jfryman/mw-cart/mega-wifi.kicad_pcb

## KiCad design mega-wifi.kicad_pcb (2026-10-06)

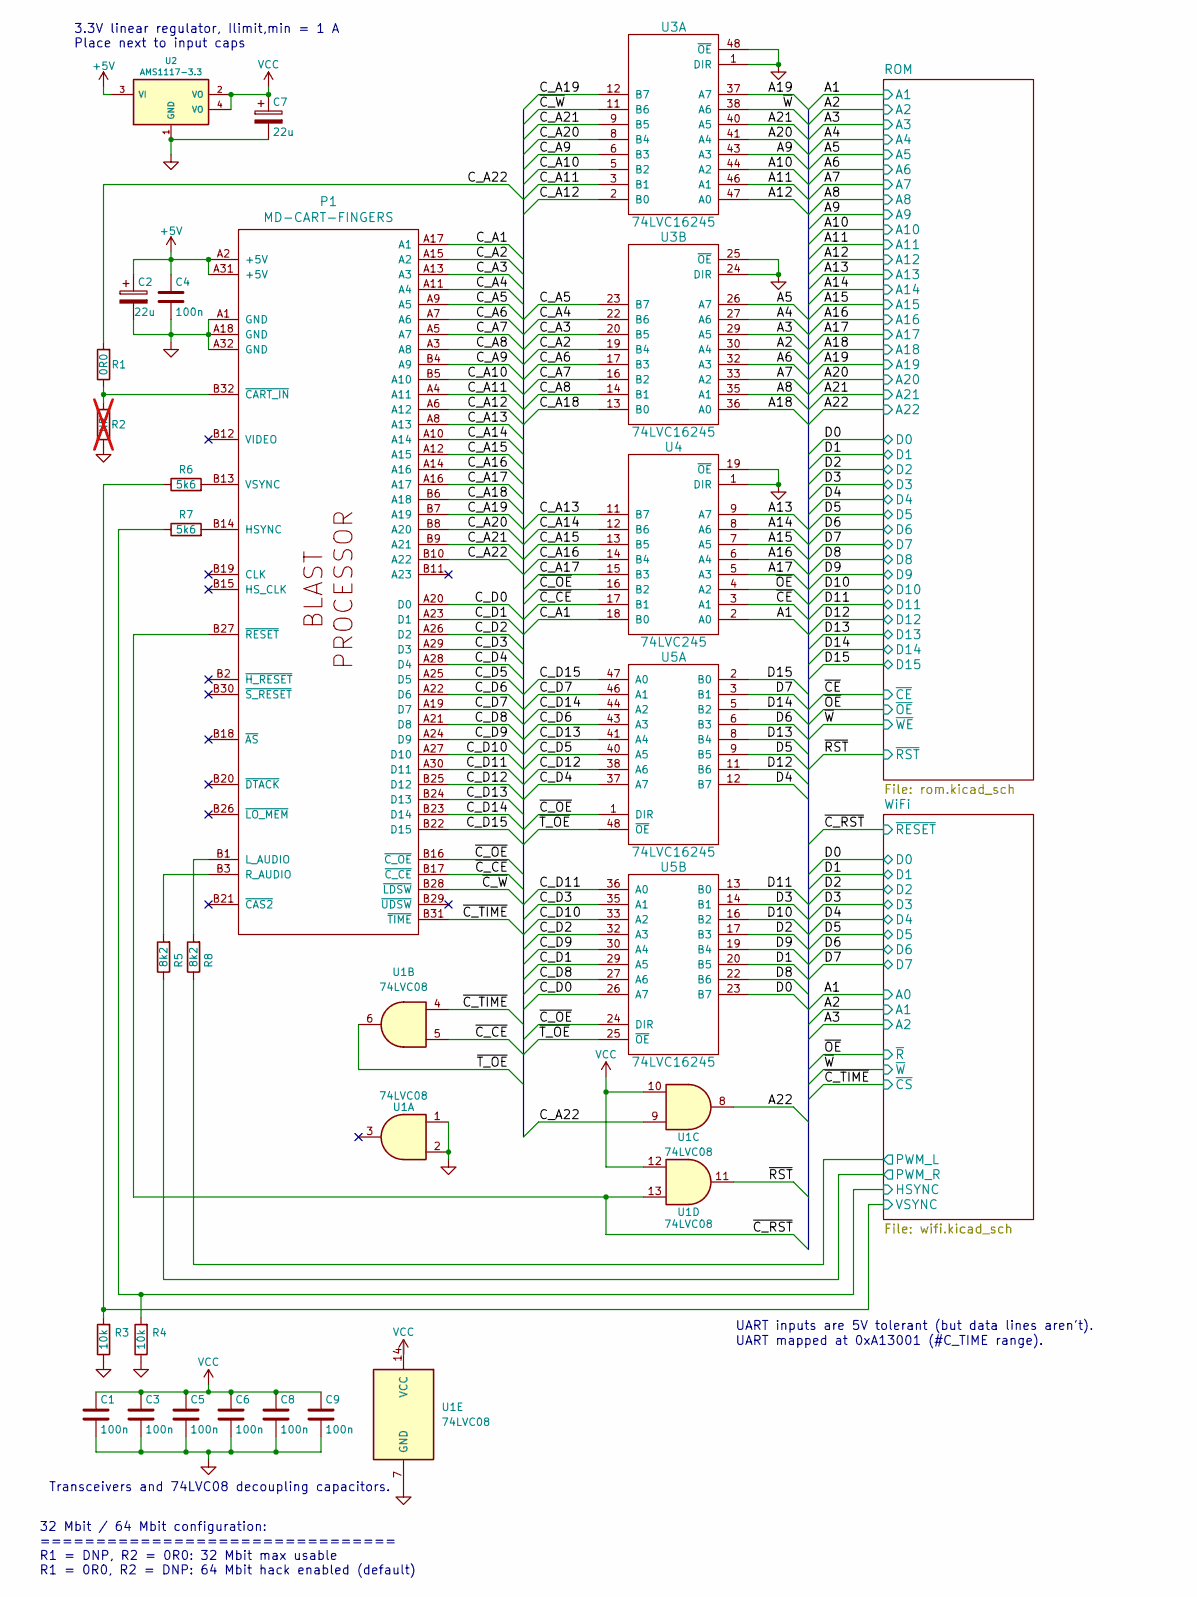
[picture p2: schematic mega-wifi.kicad_sch, MegaWiFi]

Parts:
C1, C3, C4, C5, C6, C8, C9: 100n; C_0603_1608Metric; LCSC# C14663
C2, C7: 22u; C_1206_3216Metric; LCSC# C12891
P1: MD-CART-FINGERS
R1: 0R0; R_0603_1608Metric; LCSC# C21189
R2: NP; R_0603_1608Metric; not fitted
R3, R4: 10k; R_0603_1608Metric; LCSC# C25804
R5, R8: 8k2; R_0603_1608Metric; LCSC# C25981
R6, R7: 5k6; R_0603_1608Metric; LCSC# C23189
U1: 74LVC08; TSSOP-14_4.4x5mm_P0.65mm; LCSC# C6053
U2: AMS1117-3.3; SOT-223; LCSC# C6186
U3, U5: 74LVC16245; TSSOP-48_6.1x12.5mm_P0.5mm; LCSC# C7824
U4: 74LVC245; TSSOP-20_4.4x6.5mm_P0.65mm; LCSC# C7848

Connections:
+5V: C2.1, C4.1, P1.A2 (+5V), P1.A31 (+5V), U2.3 (VI); also elsewhere on the board
/A1: U4.2 (A0); also elsewhere on the board
/A2: U3.30 (A4); also elsewhere on the board
/A3: U3.29 (A5); also elsewhere on the board
/A4: U3.27 (A6); also elsewhere on the board
/A5: U3.26 (A7); also elsewhere on the board
/A6: U3.32 (A3); also elsewhere on the board
/A7: U3.33 (A2); also elsewhere on the board
/A8: U3.35 (A1); also elsewhere on the board
/A9: U3.43 (A3); also elsewhere on the board
/A10: U3.44 (A2); also elsewhere on the board
/A11: U3.46 (A1); also elsewhere on the board
/A12: U3.47 (A0); also elsewhere on the board
/A13: U4.9 (A7); also elsewhere on the board
/A14: U4.8 (A6); also elsewhere on the board
/A15: U4.7 (A5); also elsewhere on the board
/A16: U4.6 (A4); also elsewhere on the board
/A17: U4.5 (A3); also elsewhere on the board
/A18: U3.36 (A0); also elsewhere on the board
/A19: U3.37 (A7); also elsewhere on the board
/A20: U3.41 (A4); also elsewhere on the board
/A21: U3.40 (A5); also elsewhere on the board
/A22: U1.8; also elsewhere on the board
/C_A1: P1.A17 (A1), U4.18 (B0)
/C_A2: P1.A15 (A2), U3.19 (B4)
/C_A3: P1.A13 (A3), U3.20 (B5)
/C_A4: P1.A11 (A4), U3.22 (B6)
/C_A5: P1.A9 (A5), U3.23 (B7)
/C_A6: P1.A7 (A6), U3.17 (B3)
/C_A7: P1.A5 (A7), U3.16 (B2)
/C_A8: P1.A3 (A8), U3.14 (B1)
/C_A9: P1.B4 (A9), U3.6 (B3)
/C_A10: P1.B5 (A10), U3.5 (B2)
/C_A11: P1.A4 (A11), U3.3 (B1)
/C_A12: P1.A6 (A12), U3.2 (B0)
/C_A13: P1.A8 (A13), U4.11 (B7)
/C_A14: P1.A10 (A14), U4.12 (B6)
/C_A15: P1.A12 (A15), U4.13 (B5)
/C_A16: P1.A14 (A16), U4.14 (B4)
/C_A17: P1.A16 (A17), U4.15 (B3)
/C_A18: P1.B6 (A18), U3.13 (B0)
/C_A19: P1.B7 (A19), U3.12 (B7)
/C_A20: P1.B8 (A20), U3.8 (B4)
/C_A21: P1.B9 (A21), U3.9 (B5)
/C_A22: P1.B10 (A22), R1.2, U1.9
/C_D0: P1.A20 (D0), U5.26 (A7)
/C_D1: P1.A23 (D1), U5.29 (A5)
/C_D2: P1.A26 (D2), U5.32 (A3)
/C_D3: P1.A29 (D3), U5.35 (A1)
/C_D4: P1.A28 (D4), U5.37 (A7)
/C_D5: P1.A25 (D5), U5.40 (A5)
/C_D6: P1.A22 (D6), U5.43 (A3)
/C_D7: P1.A19 (D7), U5.46 (A1)
/C_D8: P1.A21 (D8), U5.27 (A6)
/C_D9: P1.A24 (D9), U5.30 (A4)
/C_D10: P1.A27 (D10), U5.33 (A2)
/C_D11: P1.A30 (D11), U5.36 (A0)
/C_D12: P1.B25 (D12), U5.38 (A6)
/C_D13: P1.B24 (D13), U5.41 (A4)
/C_D14: P1.B23 (D14), U5.44 (A2)
/C_D15: P1.B22 (D15), U5.47 (A0)
/D0: U5.23 (B7); also elsewhere on the board
/D1: U5.20 (B5); also elsewhere on the board
/D2: U5.17 (B3); also elsewhere on the board
/D3: U5.14 (B1); also elsewhere on the board
/D4: U5.12 (B7); also elsewhere on the board
/D5: U5.9 (B5); also elsewhere on the board
/D6: U5.6 (B3); also elsewhere on the board
/D7: U5.3 (B1); also elsewhere on the board
/D8: U5.22 (B6); also elsewhere on the board
/D9: U5.19 (B4); also elsewhere on the board
/D10: U5.16 (B2); also elsewhere on the board
/D11: U5.13 (B0); also elsewhere on the board
/D12: U5.11 (B6); also elsewhere on the board
/D13: U5.8 (B4); also elsewhere on the board
/D14: U5.5 (B2); also elsewhere on the board
/D15: U5.2 (B0); also elsewhere on the board
/WiFi/HSYNC: R4.2, R7.1; also elsewhere on the board
/WiFi/PWM_L: R8.1; also elsewhere on the board
/WiFi/PWM_R: R5.1; also elsewhere on the board
/WiFi/VSYNC: R3.2, R6.1; also elsewhere on the board
/~CE: U4.3 (A1); also elsewhere on the board
/~C_CE: P1.B17 (~C_CE), U1.5, U4.17 (B1)
/~C_OE: P1.B16 (~C_OE), U4.16 (B2), U5.1 (DIR), U5.24 (DIR)
/~C_RST: P1.B27 (~RESET), U1.13; also elsewhere on the board
/~C_TIME: P1.B31 (~TIME), U1.4; also elsewhere on the board
/~C_W: P1.B28 (~LDSW), U3.11 (B6)
/~OE: U4.4 (A2); also elsewhere on the board
/~RST: U1.11; also elsewhere on the board
/~T_OE: U1.6, U5.25 (~OE), U5.48 (~OE)
/~W: U3.38 (A6); also elsewhere on the board
GND: C1.2, C2.2, C3.2, C4.2, C5.2, C6.2, C7.2, C8.2, C9.2, P1.A1 (GND), P1.A18 (GND), P1.A32 (GND), R2.1, R3.1, R4.1, U1.1, U1.2, U1.7 (GND), U2.1 (GND), U3.1 (DIR), U3.4 (GND), U3.10 (GND), U3.15 (GND), U3.21 (GND), U3.24 (DIR), U3.25 (~OE), U3.28 (GND), U3.34 (GND), U3.39 (GND), U3.45 (GND), U3.48 (~OE), U4.1 (DIR), U4.10 (GND), U4.19 (~OE), U5.4 (GND), U5.10 (GND), U5.15 (GND), U5.21 (GND), U5.28 (GND), U5.34 (GND), U5.39 (GND), U5.45 (GND); also elsewhere on the board
unnamed: P1.B14 (HSYNC), R7.2
unnamed: P1.B1 (L_AUDIO), R8.2
unnamed: P1.B3 (R_AUDIO), R5.2
unnamed: P1.B13 (VSYNC), R6.2
unnamed: P1.B32 (~CART_IN), R1.1, R2.2
VCC: C1.1, C3.1, C5.1, C6.1, C7.1, C8.1, C9.1, U1.10, U1.12, U1.14 (VCC), U2.2 (VO), U2.4 (VO), U3.7 (VCC), U3.18 (VCC), U3.31 (VCC), U3.42 (VCC), U4.20 (VCC), U5.7 (VCC), U5.18 (VCC), U5.31 (VCC), U5.42 (VCC); also elsewhere on the board

Notes on the sheet:
UART mapped at 0xA13001 (#C_TIME range).
32 Mbit / 64 Mbit configuration: ================================ R1 = DNP, R2 = 0R0: 32 Mbit max usable R1 = 0R0, R2 = DNP: 64 Mbit hack enabled (default)
Transceivers and 74LVC08 decoupling capacitors.
UART inputs are 5V tolerant (but data lines aren't).
3.3V linear regulator, Ilimit,min = 1 A Place next to input caps

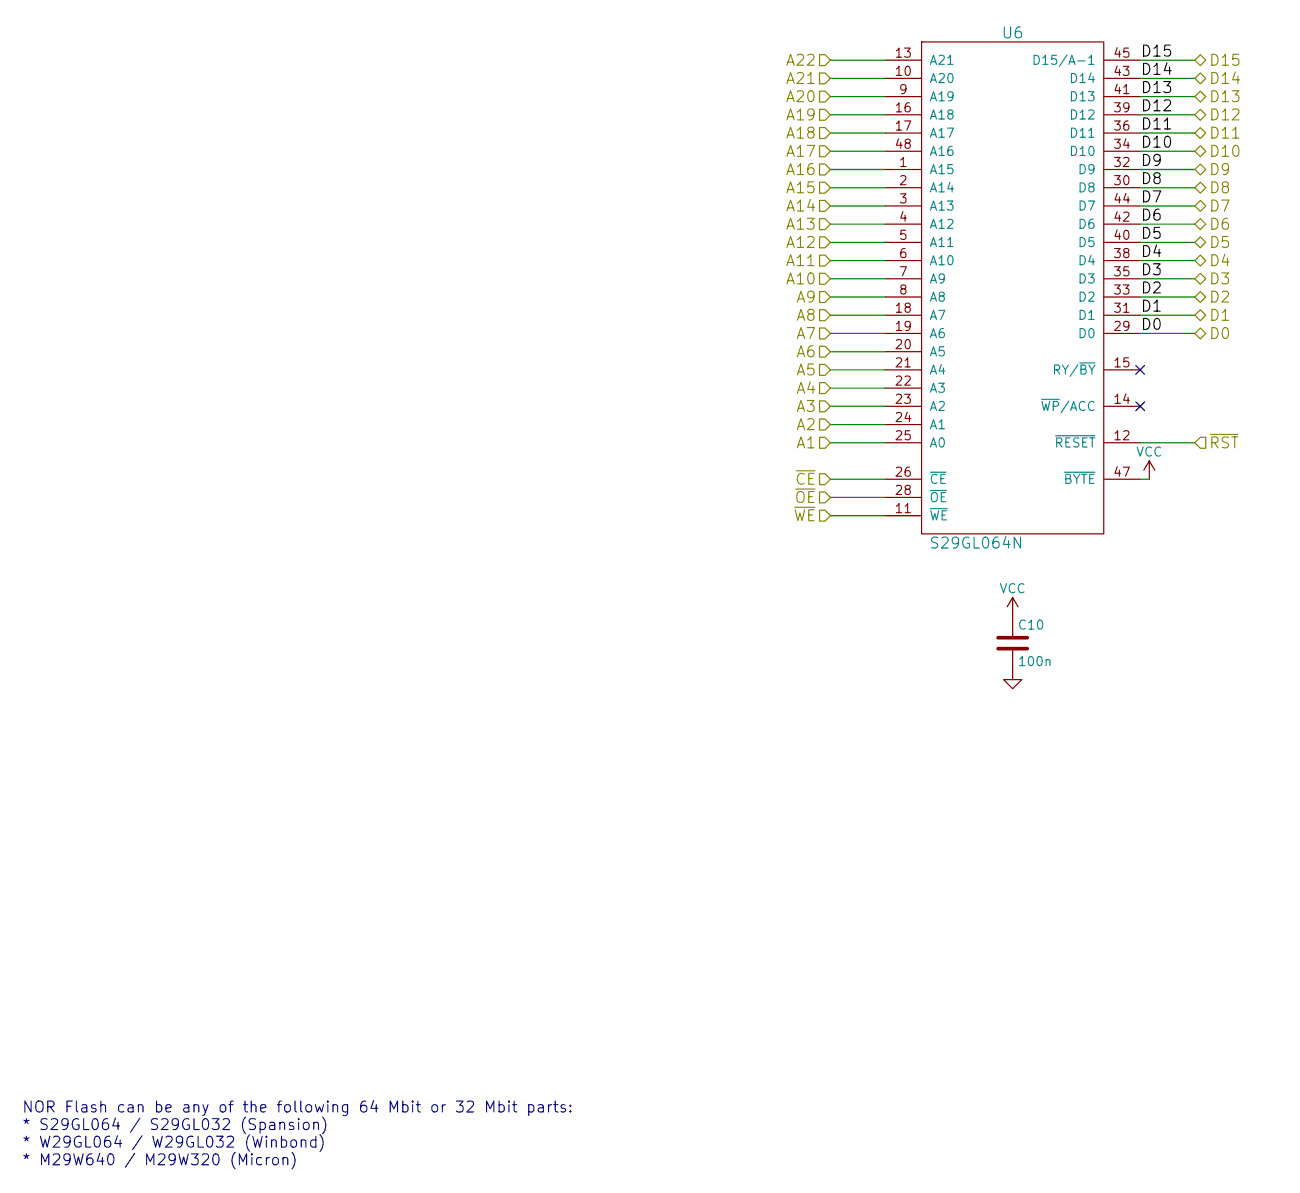
[picture p3: schematic rom.kicad_sch, MegaWiFi]

Parts:
C10: 100n; C_0603_1608Metric; LCSC# C14663
U6: S29GL064N; TSOP-I-48_18.4x12mm_P0.5mm; LCSC# C117907

Connections:
/A1: U6.25 (A0); also elsewhere on the board
/A2: U6.24 (A1); also elsewhere on the board
/A3: U6.23 (A2); also elsewhere on the board
/A4: U6.22 (A3); also elsewhere on the board
/A5: U6.21 (A4); also elsewhere on the board
/A6: U6.20 (A5); also elsewhere on the board
/A7: U6.19 (A6); also elsewhere on the board
/A8: U6.18 (A7); also elsewhere on the board
/A9: U6.8 (A8); also elsewhere on the board
/A10: U6.7 (A9); also elsewhere on the board
/A11: U6.6 (A10); also elsewhere on the board
/A12: U6.5 (A11); also elsewhere on the board
/A13: U6.4 (A12); also elsewhere on the board
/A14: U6.3 (A13); also elsewhere on the board
/A15: U6.2 (A14); also elsewhere on the board
/A16: U6.1 (A15); also elsewhere on the board
/A17: U6.48 (A16); also elsewhere on the board
/A18: U6.17 (A17); also elsewhere on the board
/A19: U6.16 (A18); also elsewhere on the board
/A20: U6.9 (A19); also elsewhere on the board
/A21: U6.10 (A20); also elsewhere on the board
/A22: U6.13 (A21); also elsewhere on the board
/D0: U6.29 (D0); also elsewhere on the board
/D1: U6.31 (D1); also elsewhere on the board
/D2: U6.33 (D2); also elsewhere on the board
/D3: U6.35 (D3); also elsewhere on the board
/D4: U6.38 (D4); also elsewhere on the board
/D5: U6.40 (D5); also elsewhere on the board
/D6: U6.42 (D6); also elsewhere on the board
/D7: U6.44 (D7); also elsewhere on the board
/D8: U6.30 (D8); also elsewhere on the board
/D9: U6.32 (D9); also elsewhere on the board
/D10: U6.34 (D10); also elsewhere on the board
/D11: U6.36 (D11); also elsewhere on the board
/D12: U6.39 (D12); also elsewhere on the board
/D13: U6.41 (D13); also elsewhere on the board
/D14: U6.43 (D14); also elsewhere on the board
/D15: U6.45 (D15/A-1); also elsewhere on the board
/~CE: U6.26 (~CE); also elsewhere on the board
/~OE: U6.28 (~OE); also elsewhere on the board
/~RST: U6.12 (~RESET); also elsewhere on the board
/~W: U6.11 (~WE); also elsewhere on the board
GND: C10.2, U6.27 (GND), U6.46 (GND); also elsewhere on the board
VCC: C10.1, U6.37 (VCC), U6.47 (~BYTE); also elsewhere on the board

Notes on the sheet:
NOR Flash can be any of the following 64 Mbit or 32 Mbit parts: * S29GL064 / S29GL032 (Spansion) * W29GL064 / W29GL032 (Winbond) * M29W640 / M29W320 (Micron)

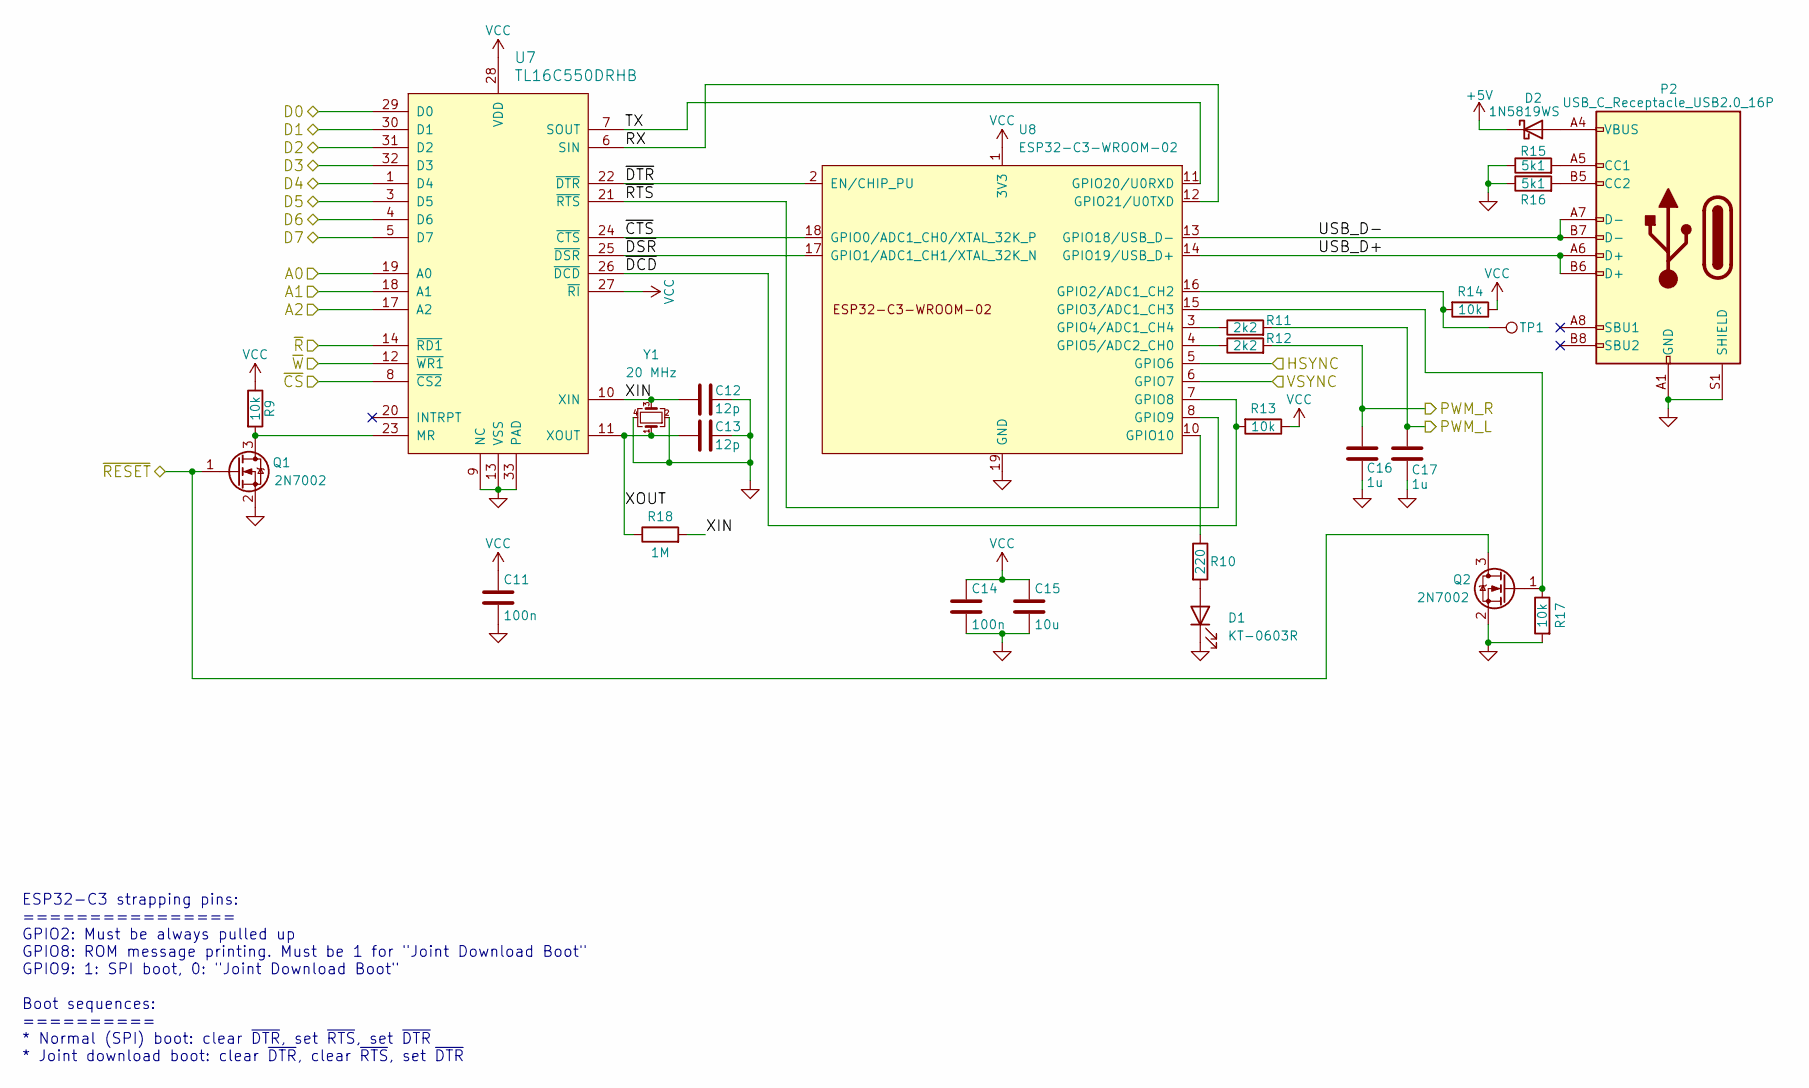
[picture p4: schematic wifi.kicad_sch, MegaWiFi]

Parts:
C11, C14: 100n; C_0603_1608Metric; LCSC# C14663
C12, C13: 12p; C_0603_1608Metric; LCSC# C38523
C15: 10u; C_0805_2012Metric; LCSC# C15850
C16, C17: 1u; C_0805_2012Metric; LCSC# C28323
D1: KT-0603R; LED_0603_1608Metric; LCSC# C2286
D2: 1N5819WS; D_SOD-323; LCSC# C191023
P2: USB_C_Receptacle_USB2.0_16P; USB_C_Receptacle_HCTL_HC-TYPE-C-16P-01A; LCSC# C709357
Q1, Q2: 2N7002; SOT-23; LCSC# C8545
R9, R13, R14, R17: 10k; R_0603_1608Metric; LCSC# C25804
R10: 220; R_0603_1608Metric; LCSC# C22962
R11, R12: 2k2; R_0603_1608Metric; LCSC# C4177
R15, R16: 5k1; R_0402_1005Metric; LCSC# C25905
R18: 1M; R_0402_1005Metric; LCSC# C26083
TP1: TestPoint; TestPoint_Pad_D1.0mm
U7: TL16C550DRHB; Texas_RHB0032E_VQFN-32-1EP_5x5mm_P0.5mm_EP3.45x3.45mm; LCSC# C2653239
U8: ESP32-C3-WROOM-02; LCSC# C2934560
Y1: 20 MHz; Crystal_SMD_2520-4Pin_2.5x2.0mm; LCSC# C252261

Connections:
+5V: D2.1 (K); also elsewhere on the board
/A1: U7.19 (A0); also elsewhere on the board
/A2: U7.18 (A1); also elsewhere on the board
/A3: U7.17 (A2); also elsewhere on the board
/D0: U7.29 (D0); also elsewhere on the board
/D1: U7.30 (D1); also elsewhere on the board
/D2: U7.31 (D2); also elsewhere on the board
/D3: U7.32 (D3); also elsewhere on the board
/D4: U7.1 (D4); also elsewhere on the board
/D5: U7.3 (D5); also elsewhere on the board
/D6: U7.4 (D6); also elsewhere on the board
/D7: U7.5 (D7); also elsewhere on the board
/WiFi/HSYNC: U8.5 (GPIO6); also elsewhere on the board
/WiFi/PWM_L: C17.1, R11.2; also elsewhere on the board
/WiFi/PWM_R: C16.1, R12.2; also elsewhere on the board
/WiFi/RX: U7.6 (SIN), U8.12 (GPIO21/U0TXD)
/WiFi/TX: U7.7 (SOUT), U8.11 (GPIO20/U0RXD)
/WiFi/USB_D+: P2.A6 (D+), P2.B6 (D+), U8.14 (GPIO19/USB_D+)
/WiFi/USB_D-: P2.A7 (D-), P2.B7 (D-), U8.13 (GPIO18/USB_D-)
/WiFi/VSYNC: U8.6 (GPIO7); also elsewhere on the board
/WiFi/XIN: C12.2, R18.2, U7.10 (XIN), Y1.3
/WiFi/XOUT: C13.2, R18.1, U7.11 (XOUT), Y1.1
/WiFi/~CTS: U7.24 (~CTS), U8.18 (GPIO0/ADC1_CH0/XTAL_32K_P)
/WiFi/~DCD: R13.2, U7.26 (~DCD), U8.7 (GPIO8)
/WiFi/~DSR: U7.25 (~DSR), U8.17 (GPIO1/ADC1_CH1/XTAL_32K_N)
/WiFi/~DTR: U7.22 (~DTR), U8.2 (EN/CHIP_PU)
/WiFi/~RTS: U7.21 (~RTS), U8.8 (GPIO9)
/~C_RST: Q1.1 (G), Q2.3 (D); also elsewhere on the board
/~C_TIME: U7.8 (~CS2); also elsewhere on the board
/~OE: U7.14 (~RD1); also elsewhere on the board
/~W: U7.12 (~WR1); also elsewhere on the board
GND: C11.2, C12.1, C13.1, C14.2, C15.2, C16.2, C17.2, D1.1 (K), P2.A1 (GND), P2.A12 (GND), P2.B1 (GND), P2.B12 (GND), P2.S1 (SHIELD), Q1.2 (S), Q2.2 (S), R15.1, R16.1, R17.2, U7.9 (NC), U7.13 (VSS), U7.33 (PAD), U8.9 (GND), U8.19 (GND), Y1.2, Y1.4; also elsewhere on the board
unnamed: D1.2 (A), R10.2
unnamed: D2.2 (A), P2.A4 (VBUS), P2.A9 (VBUS), P2.B4 (VBUS), P2.B9 (VBUS)
unnamed: P2.A5 (CC1), R15.2
unnamed: P2.B5 (CC2), R16.2
unnamed: Q1.3 (D), R9.2, U7.23 (MR)
unnamed: Q2.1 (G), R17.1, U8.15 (GPIO3/ADC1_CH3)
unnamed: R14.2, TP1.1, U8.16 (GPIO2/ADC1_CH2)
unnamed: R11.1, U8.3 (GPIO4/ADC1_CH4)
unnamed: R12.1, U8.4 (GPIO5/ADC2_CH0)
unnamed: R10.1, U8.10 (GPIO10)
VCC: C11.1, C14.1, C15.1, R9.1, R13.1, R14.1, U7.27 (~RI), U7.28 (VDD), U8.1 (3V3); also elsewhere on the board

Notes on the sheet:
ESP32-C3 strapping pins: ================ GPIO2: Must be always pulled up GPIO8: ROM message printing. Must be 1 for "Joint Download Boot" GPIO9: 1: SPI boot, 0: "Joint Download Boot" Boot sequences: ========== * Normal (SPI) boot: clear ~{DTR}, set ~{RTS}, set ~{DTR} * Joint download boot: clear ~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

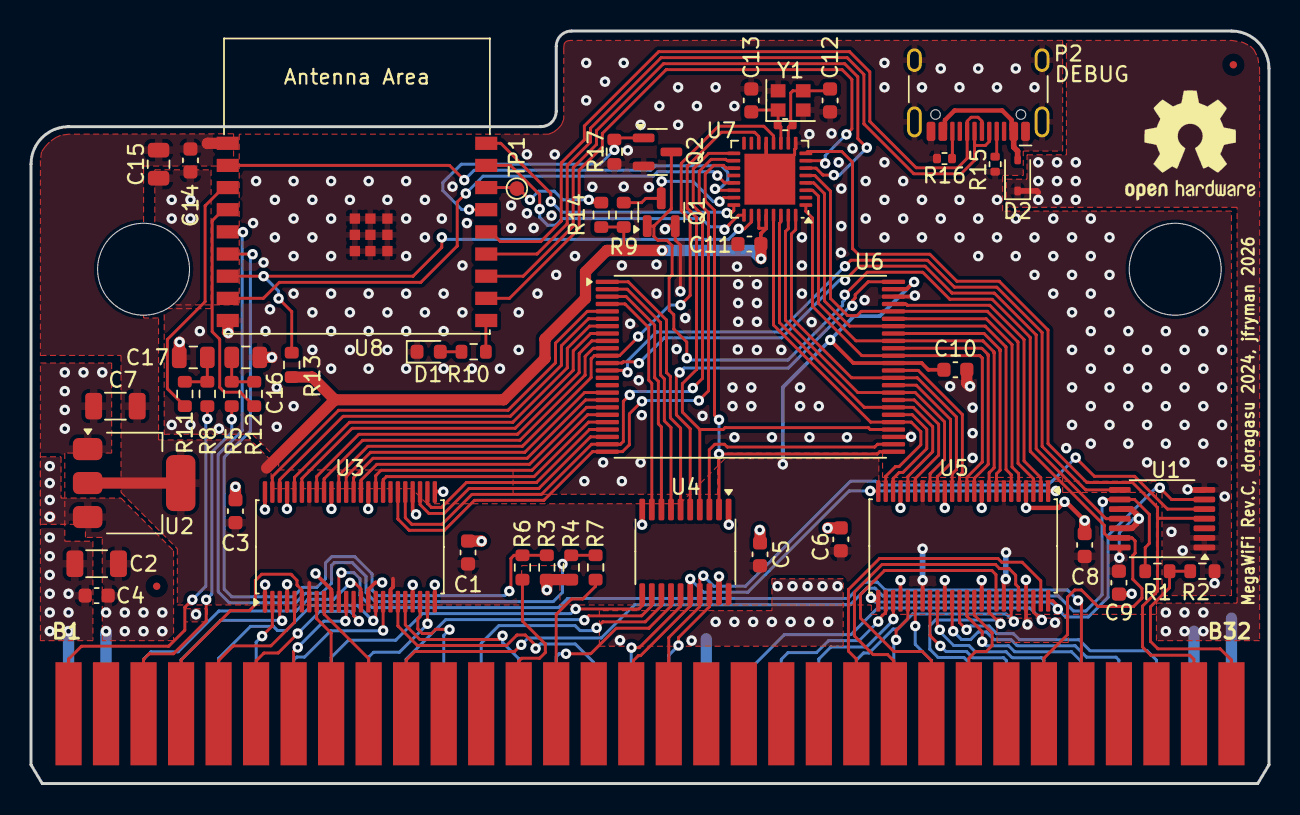
[picture p5: board mega-wifi.kicad_pcb from above]

Board: 2 copper layers, 83.8 x 51.0 mm, 51 parts (0 on the bottom side), 119 nets.
