jfryman/mw-cart/(commit log)

2023-04-23 Update to KiCad 7
    [mega-wifi.kicad_pcb, mega-wifi.kicad_sch, mega-wifi.sch, rom.kicad_sch, rom.sch, wifi.kicad_sch, wifi.sch]
2023-04-23 Add CI/CD Kibot integration
    [mega-wifi-B_Cu.gbr, mega-wifi-B_Mask.gbr, mega-wifi-Edge_Cuts.gbr, mega-wifi-F_Cu.gbr, mega-wifi-F_Mask.gbr, mega-wifi-F_Paste.gbr, mega-wifi-F_SilkS.gbr, mega-wifi-NPTH.drl]
2023-04-23 Minor tweaks
    [mega-wifi.kicad_pcb]
2024-09-29 Update schematics for Rev.B:
    * Switch obsolete SC16C554BIB48 with SC16C554BIBS
    * Change ESP8266 with ESP32-C3
    * Add USB-C connector for flashing/debugging
    [mega-wifi.kicad_sch, rom.kicad_sch, wifi.kicad_sch]
2024-10-07 Rev.B PCB
    * Replace obsolete SC16C550BIB48 with SC16C550BIBS
    * Replace ESP8266 with ESP32-C3
    * Implement 64 Mbit hack
    * Add USB-C debug header for ESP32-C3
    * Many PCB improvements
    [mega-wifi.kicad_pcb, mega-wifi.kicad_sch, rom.kicad_sch, wifi.kicad_sch]
2024-10-07 Use KiCAD 8 KiBot image
2024-10-08 Fabrication tweaks
    [mega-wifi.kicad_pcb, mega-wifi.kicad_sch, rom.kicad_sch, wifi.kicad_sch]
2024-10-09 Allow ESP32 to reset the host
    [mega-wifi.kicad_pcb, mega-wifi.kicad_sch, wifi.kicad_sch]
2024-12-04 Update README.md with PCB fabrication instructions for JLCPCB
2026-10-06 Rev.C: replace SC16C550BIBS with TI TL16C550DRHB
    The NXP SC16C550BIBS is out of stock everywhere. The TI TL16C550D in the
    RHB (5x5 VQFN-32) package is pin-for-pin compatible and register
    compatible (auto RTS/CTS via MCR AFE), so the existing driver works.
    - U7: TL16C550DRHB (LCSC C2653239), Texas RHB0032E footprint (EP 3.45 mm,
    perimeter pads unchanged); pin names updated to TI naming.
    - Y1: 20 MHz crystal (TXC 7E20000E12UCG, C252261, 12 pF load). TI rates
    the RHB package to 20 MHz at 3.3 V, so the UART link runs at
    1.25 Mbaud (divisor 1). SGDK 16c550.h and mw-fw-rtos LSD_UART_BR must
    be set to match; existing ROMs/firmware at 1.5 Mbaud will not work.
    - R18: 1 MOhm oscillator bias r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
    [mega-wifi.kicad_pcb, mega-wifi.kicad_sch, rom.kicad_sch, wifi.kicad_sch]
2026-10-28 tools: kicad-cli build wrapper and s-expression helpers used for Rev.C
    apply_tl16c550d.py performed the U7 swap at text level so the sources stay
    in KiCad 8 format. build_outputs.py rebuilds the JLC/doc outputs with
    kicad-cli. fetch-ext.sh fetches the Espressif 3D models (pinned).
2026-10-28 bringup-rom: standalone 68000 test ROM for Rev.C boards
    Tests U7 (bus, decode, loopback, crystal), the ESP32 link at 1.25 Mbaud,
    and flash A17-A22 including the flat-8MiB ~CART_IN hack. Includes a MAME
    UART/ESP32 model and FlashKit MD helpers (fk_probe.py, fk_hiflash.py).
2026-10-28 Build tooling: run on Linux or macOS
    - build_outputs.py, tools/kc and the new tools/kipy find KiCad by lookup
    order ($KICAD_CLI / PATH / KiCad.app / flatpak) and default the 3D
    library to that install's. A macOS build of rev-c-1 matches the Fedora
    flatpak release outputs (BOM/CPL byte-identical, Gerbers/drill identical
    apart from date lines).
    - bringup-rom/container.sh + Containerfile: m68k gcc and MAME in a Fedora
    container via podman or docker, so the ROM builds and simulates the same
    on both.
    - Drop tools/hostbin: the shims were specific to KiBot-in-flatpak on an
    aarch64 Fedora host.
    - fk_probe.py finds the FlashKit on either OS; ignore *.kicad_prl.
    - README and lode: platfo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
