jfryman/mw-cart/(notices)

Notices in the files:
mega-wifi.kicad_sch:
License: CERN OHL 1.2
